mckay27/hstat/HW/doc/GDEY42T81-FT02-CAD_00.png

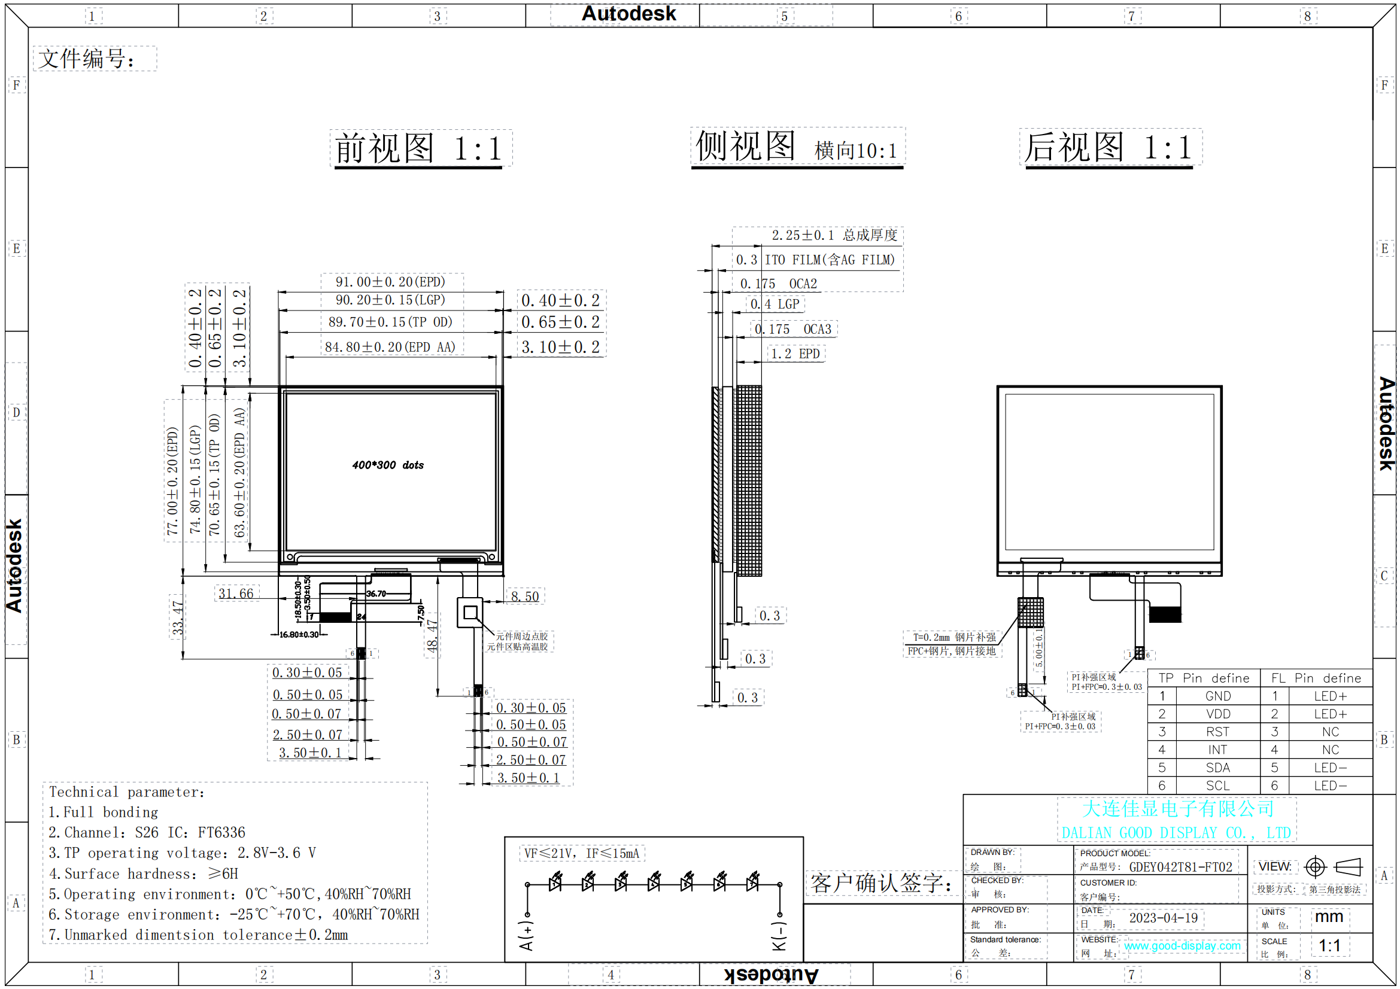
HW/doc/GDEY42T81-FT02-CAD_00.png
