mckay27/hstat/HW/3d-models/display_board.step

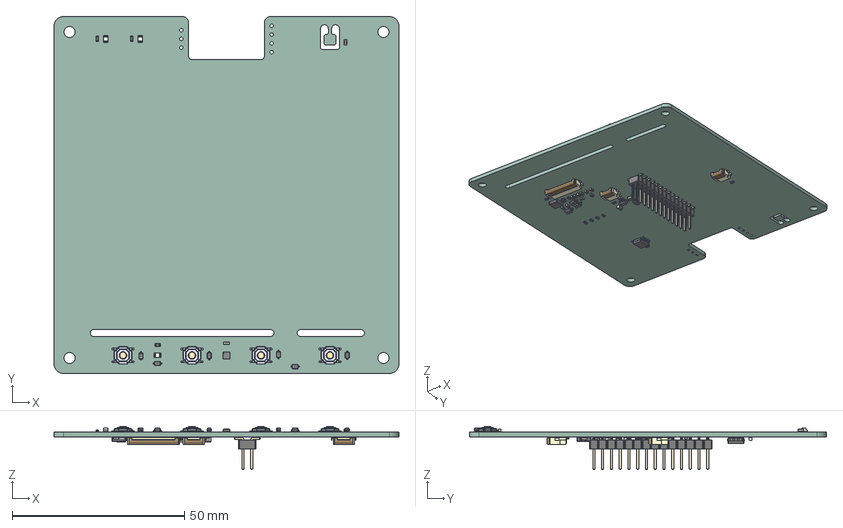
[picture p2: CAD file, 2026-02-15]
HW/3d-models/display_board.step
100.0 x 103.5 x 12.5 mm
R_0603_1608Metric x 11
D_SOD-323 x 6
TS-1187A-B-A-B x 4
LTR-303ALS-01_LTO
LED_0805_2012Metric x 3
C_0603_1608Metric x 14
lock x 3
pins x 3
C_0805_2012Metric x 2
L_Changjiang_FNR4012S
D_SOD-123 x 4
SOT-23-6
PinHeader_2x14_P2.54mm_Vertical_SMD
SOIC-8_3.9x4.9mm_P1.27mm
SOT-323_SC-70
display_board_PCB
