mckay27/hstat/HW/display_board/3d-models/LTR-303ALS-01_LTO.step

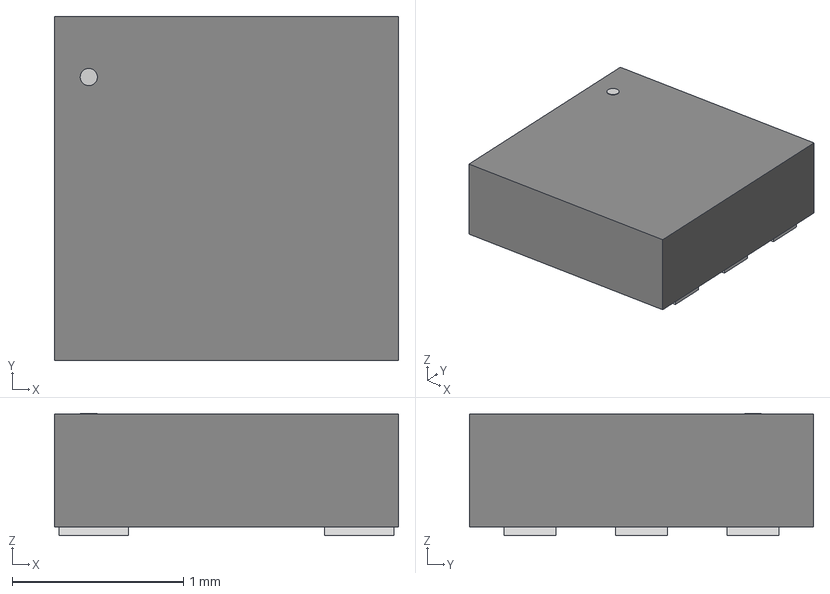
[picture p3: CAD file, 2026-02-15]
HW/display_board/3d-models/LTR-303ALS-01_LTO.step
2.01 x 2.01 x 0.714 mm
