mckay27/hstat/HW/main_board/3d-models/TS-1187A-B-A-B.STEP

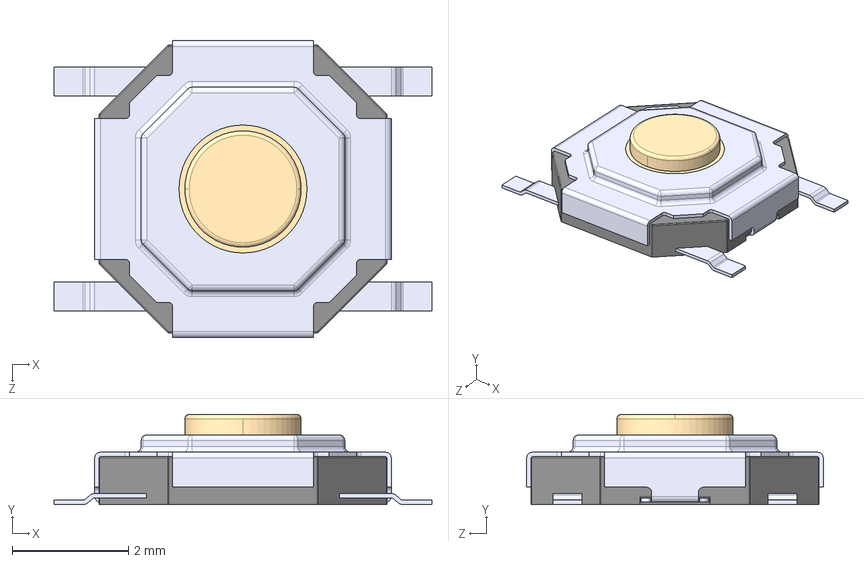
[picture p4: CAD file, 2026-02-15]
HW/main_board/3d-models/TS-1187A-B-A-B.STEP
6.50 x 1.55 x 5.10 mm
