mckay27/hstat/HW/display_board/display_board.kicad_pcb

## KiCad design HW/display_board/display_board.kicad_pcb (2026-02-26)

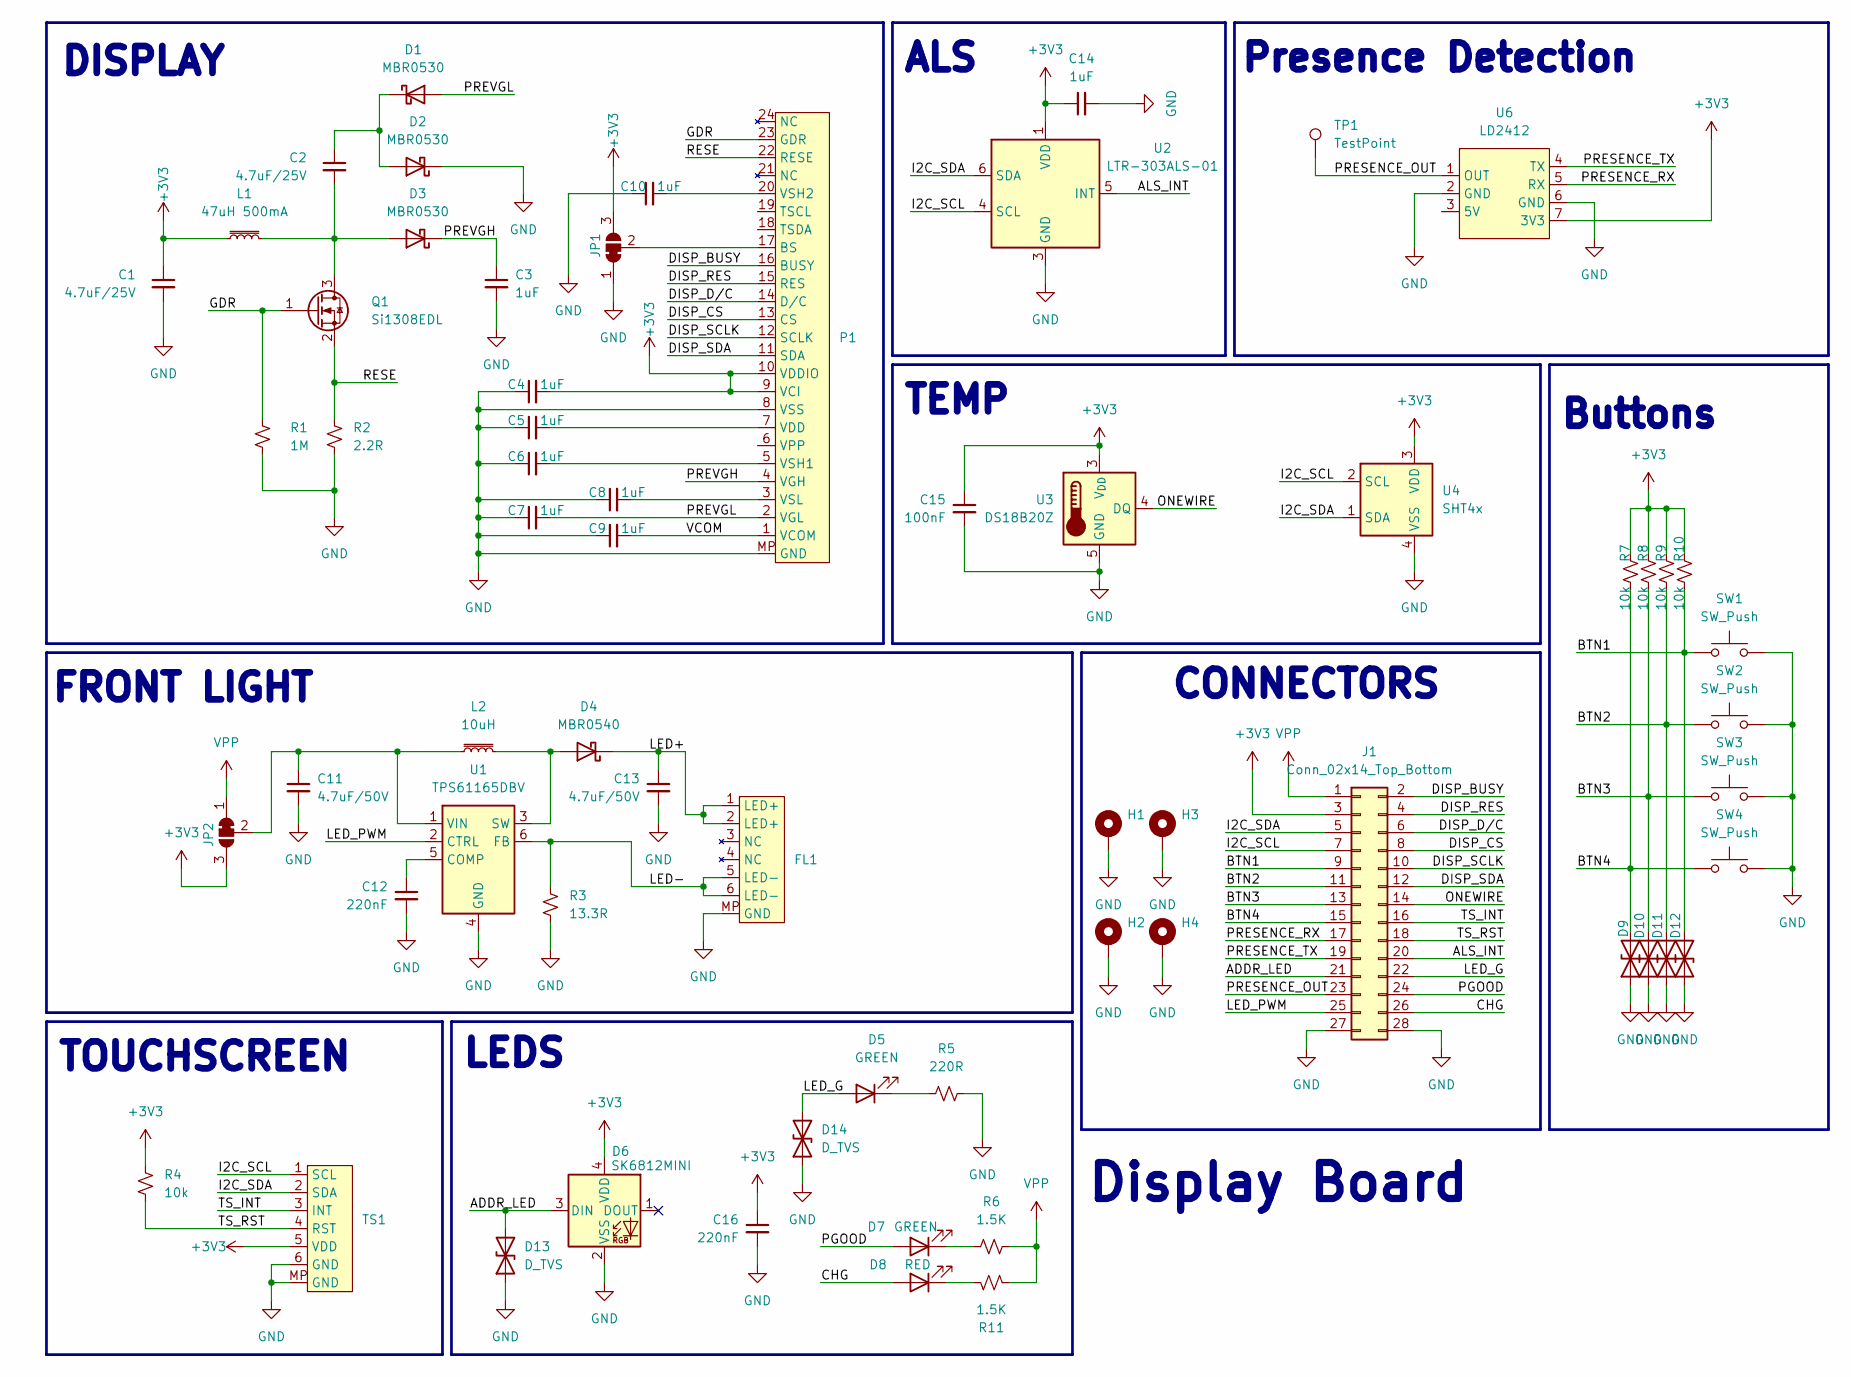
[picture p5: schematic display_board.kicad_sch, hstat display board]

Parts:
C1, C2: 4.7uF/25V; C_0603_1608Metric; PartsBox ID aw5pxnppqwhgq9d4hbptg59tfp
C3, C4, C5, C6, C7, C8, C9, C10, C14: 1uF; C_0603_1608Metric; PartsBox ID 6kadbs4vvekm59a2tdn2x98ymn
C11, C13: 4.7uF/50V; C_0805_2012Metric; PartsBox ID 7j02rd1hp8ghk8tj1z507f8pqg
C12, C16: 220nF; C_0603_1608Metric; PartsBox ID bsj51sepbckhc9y04nejax5532
C15: 100nF; C_0603_1608Metric; PartsBox ID 6afr1f2my2jjj8vs6v1p4rpr25
D1, D2, D3: MBR0530; D_SOD-123; MPN MBR0530-TP
D4: MBR0540; D_SOD-123; PartsBox ID 77578v3zwgkcma6xaqdbw1041c
D5, D7: GREEN; LED_0805_2012Metric; MPN KT-0805G
D6: SK6812MINI; LED_SK6812MINI_PLCC4_3.5x3.5mm_P1.75mm; MPN SK6812MINI-HS
D8: RED; LED_0805_2012Metric; MPN NCD0805R1
D9, D10, D11, D12, D13, D14: D_TVS; D_SOD-323; MPN H8VHD3B
FL1: AFC24-S06FIA-00
H1, H2, H3, H4: MountingHole_Pad; MountingHole_3.2mm_M3_ISO7380
J1: Conn_02x14_Top_Bottom; PinHeader_2x14_P2.54mm_Vertical_SMD
JP1, JP2: SolderJumper_3_Bridged12; SolderJumper-3_P1.3mm_Bridged12_RoundedPad1.0x1.5mm
L1: 47uH 500mA; L_Changjiang_FNR4012S; MPN FNR4012S470MT
L2: 10uH; L_Taiyo-Yuden_NR-40xx; MPN NRS4018T100MDGJ
P1: AFC24-S24FIA-00
Q1: Si1308EDL; SOT-323_SC-70; MPN SI1308EDL-T1-GE3
R1: 1M; R_0603_1608Metric; PartsBox ID 6jt3vpkk78jdvawzvaeg0wm6yf
R2: 2.2R; R_0603_1608Metric; PartsBox ID 8vn7xtt6zthxrb24xq1m7pnxd6
R3: 13.3R; R_0603_1608Metric; PartsBox ID 251d633bemhrbapgvqna90sr9j
R4, R7, R8, R9, R10: 10k; R_0603_1608Metric; PartsBox ID df49r6pnvckv7ajxacv2mbgt3r
R5: 220R; R_0603_1608Metric; PartsBox ID 1qgbwbrhs2jpe97grc235zphth
R6, R11: 1.5K; R_0603_1608Metric; PartsBox ID 8a565xcwbcjcr9p1vng5eaq7bh
SW1, SW2, SW3, SW4: SW_Push; SW_Push_1P1T_XKB_TS-1187A; MPN TS-1187A-B-A-B
TP1: TestPoint; TestPoint_Pad_2.0x2.0mm
TS1: AFC24-S06FIA-00
U1: TPS61165DBV; SOT-23-6; MPN TPS61165DBV
U2: LTR-303ALS-01; Lite-On_LTR-303ALS-01; MPN LTR-303ALS-01
U3: DS18B20Z; SOIC-8_3.9x4.9mm_P1.27mm; MPN DS18B20Z
U4: SHT4x; Sensirion_DFN-4_1.5x1.5mm_P0.8mm_SHT4x_NoCentralPad; MPN SHT41-AD1B-R2
U6: LD2412; MPN LD2412

Connections:
+3V3: C1.1, C4.2, C14.1, C15.1, C16.1, D6.4 (VDD), J1.3, JP1.3 (B), JP2.3 (B), L1.1, P1.9 (VCI), P1.10 (VDDIO), R4.1, R7.1, R8.1, R9.1, R10.1, TS1.5 (VDD), U2.1 (VDD), U3.3 (V_{DD}), U4.3 (VDD), U6.7 (3V3)
/ADDR_LED: D6.3 (DIN), D13.2 (A2), J1.21
/ALS_INT: J1.20, U2.5 (INT)
/BTN1: D12.2 (A2), J1.9, R10.2, SW1.1
/BTN2: D11.2 (A2), J1.11, R9.2, SW2.1
/BTN3: D10.2 (A2), J1.13, R8.2, SW3.1
/BTN4: D9.2 (A2), J1.15, R7.2, SW4.1
/CHG: D8.2 (A), J1.26
/DISP_BUSY: J1.2, P1.16 (BUSY)
/DISP_CS: J1.8, P1.13 (CS)
/DISP_D/C: J1.6, P1.14 (D/C)
/DISP_RES: J1.4, P1.15 (RES)
/DISP_SCLK: J1.10, P1.12 (SCLK)
/DISP_SDA: J1.12, P1.11 (SDA)
/GDR: P1.23 (GDR), Q1.1 (G), R1.1
/I2C_SCL: J1.7, TS1.1 (SCL), U2.4 (SCL), U4.2 (SCL)
/I2C_SDA: J1.5, TS1.2 (SDA), U2.6 (SDA), U4.1 (SDA)
/LED+: C13.1, D4.1 (K), FL1.1 (LED+), FL1.2 (LED+)
/LED-: FL1.5 (LED-), FL1.6 (LED-), R3.1, U1.6 (FB)
/LED_G: D5.2 (A), D14.2 (A2), J1.22
/LED_PWM: J1.25, U1.2 (CTRL)
/ONEWIRE: J1.14, U3.4 (DQ)
/PGOOD: D7.2 (A), J1.24
/PRESENCE_OUT: J1.23, TP1.1, U6.1 (OUT)
/PRESENCE_RX: J1.17, U6.5 (RX)
/PRESENCE_TX: J1.19, U6.4 (TX)
/PREVGH: C3.1, D3.1 (K), P1.4 (VGH)
/PREVGL: C7.2, D1.2 (A), P1.2 (VGL)
/RESE: P1.22 (RESE), Q1.2 (S), R2.1
/TS_INT: J1.16, TS1.3 (INT)
/TS_RST: J1.18, R4.2, TS1.4 (RST)
/VCOM: C9.2, P1.1 (VCOM)
GND: C1.2, C3.2, C4.1, C5.1, C6.1, C7.1, C8.1, C9.1, C10.1, C11.2, C12.2, C13.2, C14.2, C15.2, C16.2, D2.1 (K), D6.2 (VSS), D9.1 (A1), D10.1 (A1), D11.1 (A1), D12.1 (A1), D13.1 (A1), D14.1 (A1), FL1.MP (GND), H1.1, H2.1, H3.1, H4.1, J1.27, J1.28, JP1.1 (A), P1.8 (VSS), P1.MP (GND), R1.2, R2.2, R3.2, R5.2, SW1.2, SW2.2, SW3.2, SW4.2, TS1.6 (GND), TS1.MP (GND), U1.4 (GND), U2.3 (GND), U3.5 (GND), U4.4 (VSS), U6.2 (GND), U6.6 (GND)
unnamed: C2.1, D1.1 (K), D2.2 (A)
unnamed: C2.2, D3.2 (A), L1.2, Q1.3 (D)
unnamed: D4.2 (A), L2.2, U1.3 (SW)
unnamed: D5.1 (K), R5.1
unnamed: D7.1 (K), R6.2
unnamed: D8.1 (K), R11.1
unnamed: JP1.2 (C), P1.17 (BS)
unnamed: C11.1, JP2.2 (C), L2.1, U1.1 (VIN)
unnamed: C5.2, P1.7 (VDD)
unnamed: C6.2, P1.5 (VSH1)
unnamed: C10.2, P1.20 (VSH2)
unnamed: C8.2, P1.3 (VSL)
unnamed: C12.1, U1.5 (COMP)
VPP: J1.1, JP2.1 (A), R6.1, R11.2

Notes on the sheet:
DISPLAY
Presence Detection
TEMP
Display Board
LEDS
CONNECTORS
Buttons
TOUCHSCREEN
ALS
FRONT LIGHT

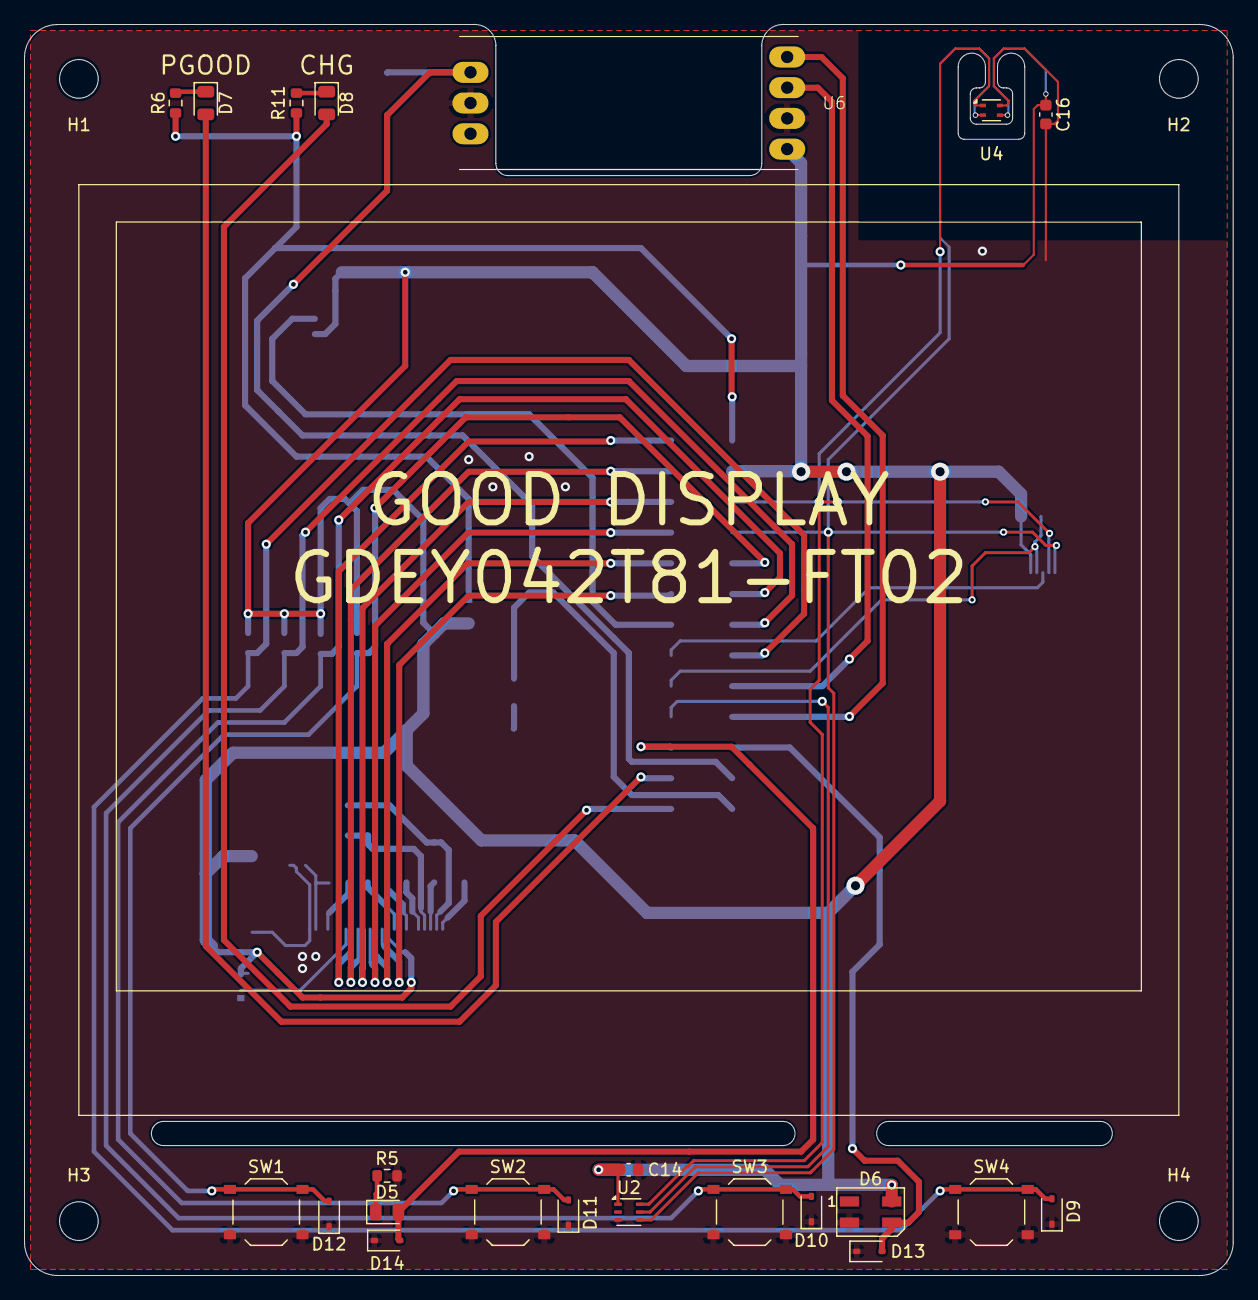
[picture p6: board display_board.kicad_pcb from above]

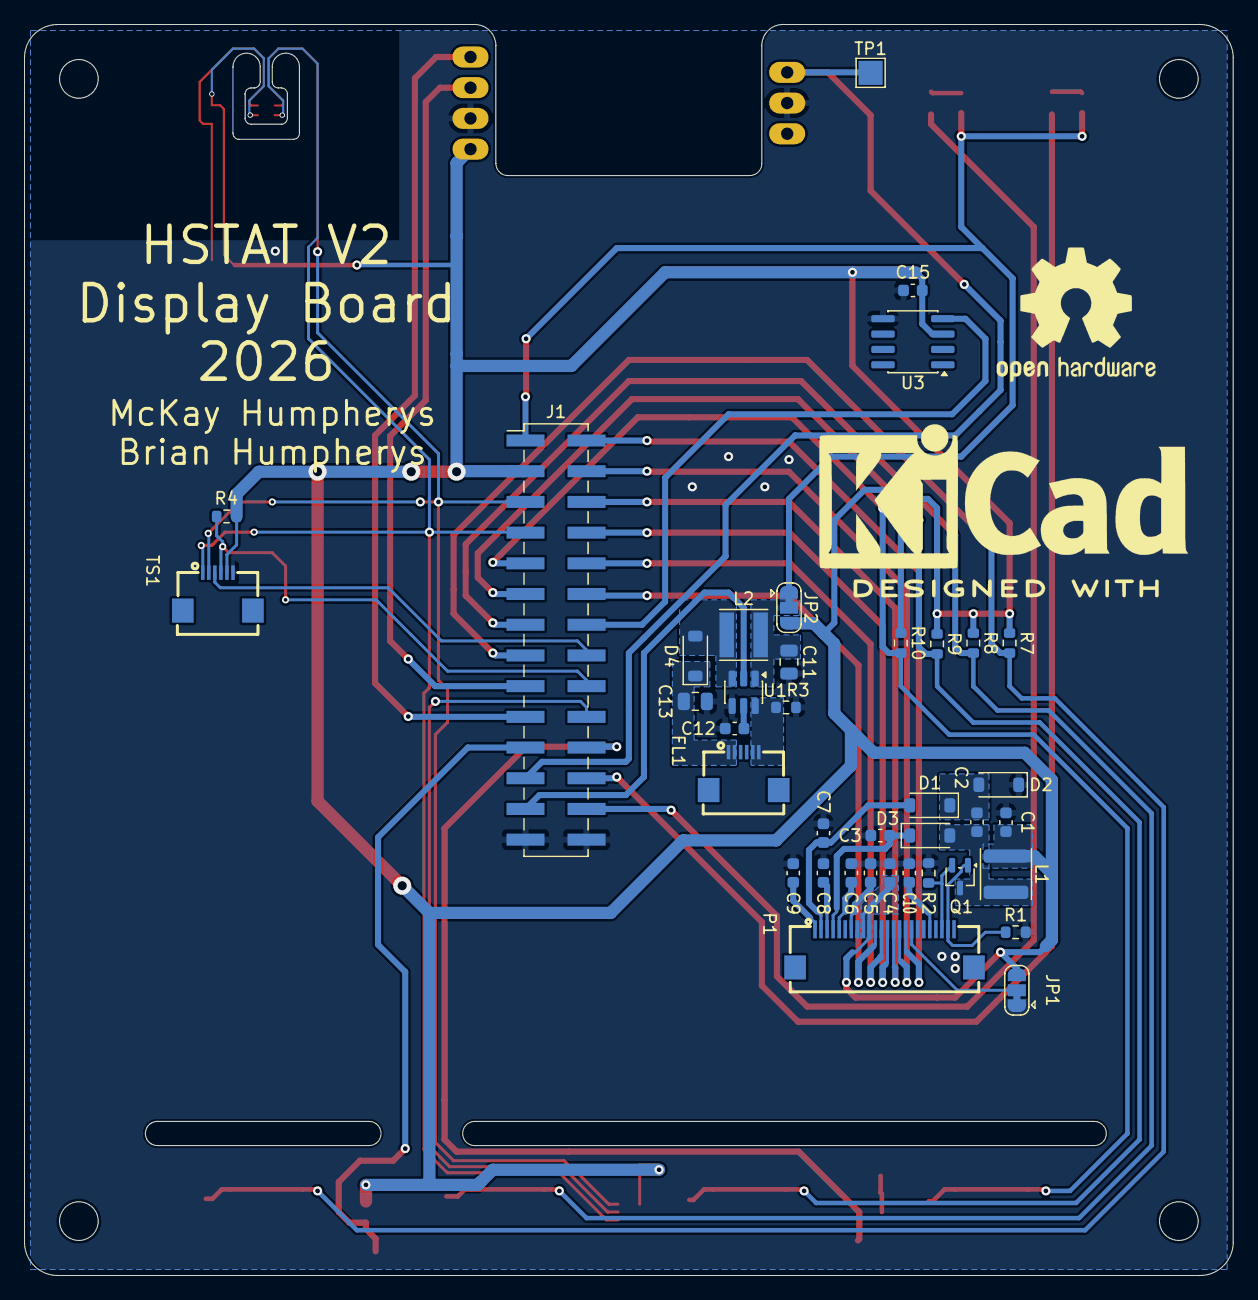
[picture p7: board display_board.kicad_pcb from below]

Board: 2 copper layers, 100.0 x 103.5 mm, 64 parts (38 on the bottom side), 47 nets.
