mckay27/hstat/HW/main_board/main_board.kicad_pcb

## KiCad design HW/main_board/main_board.kicad_pcb (2026-02-16)

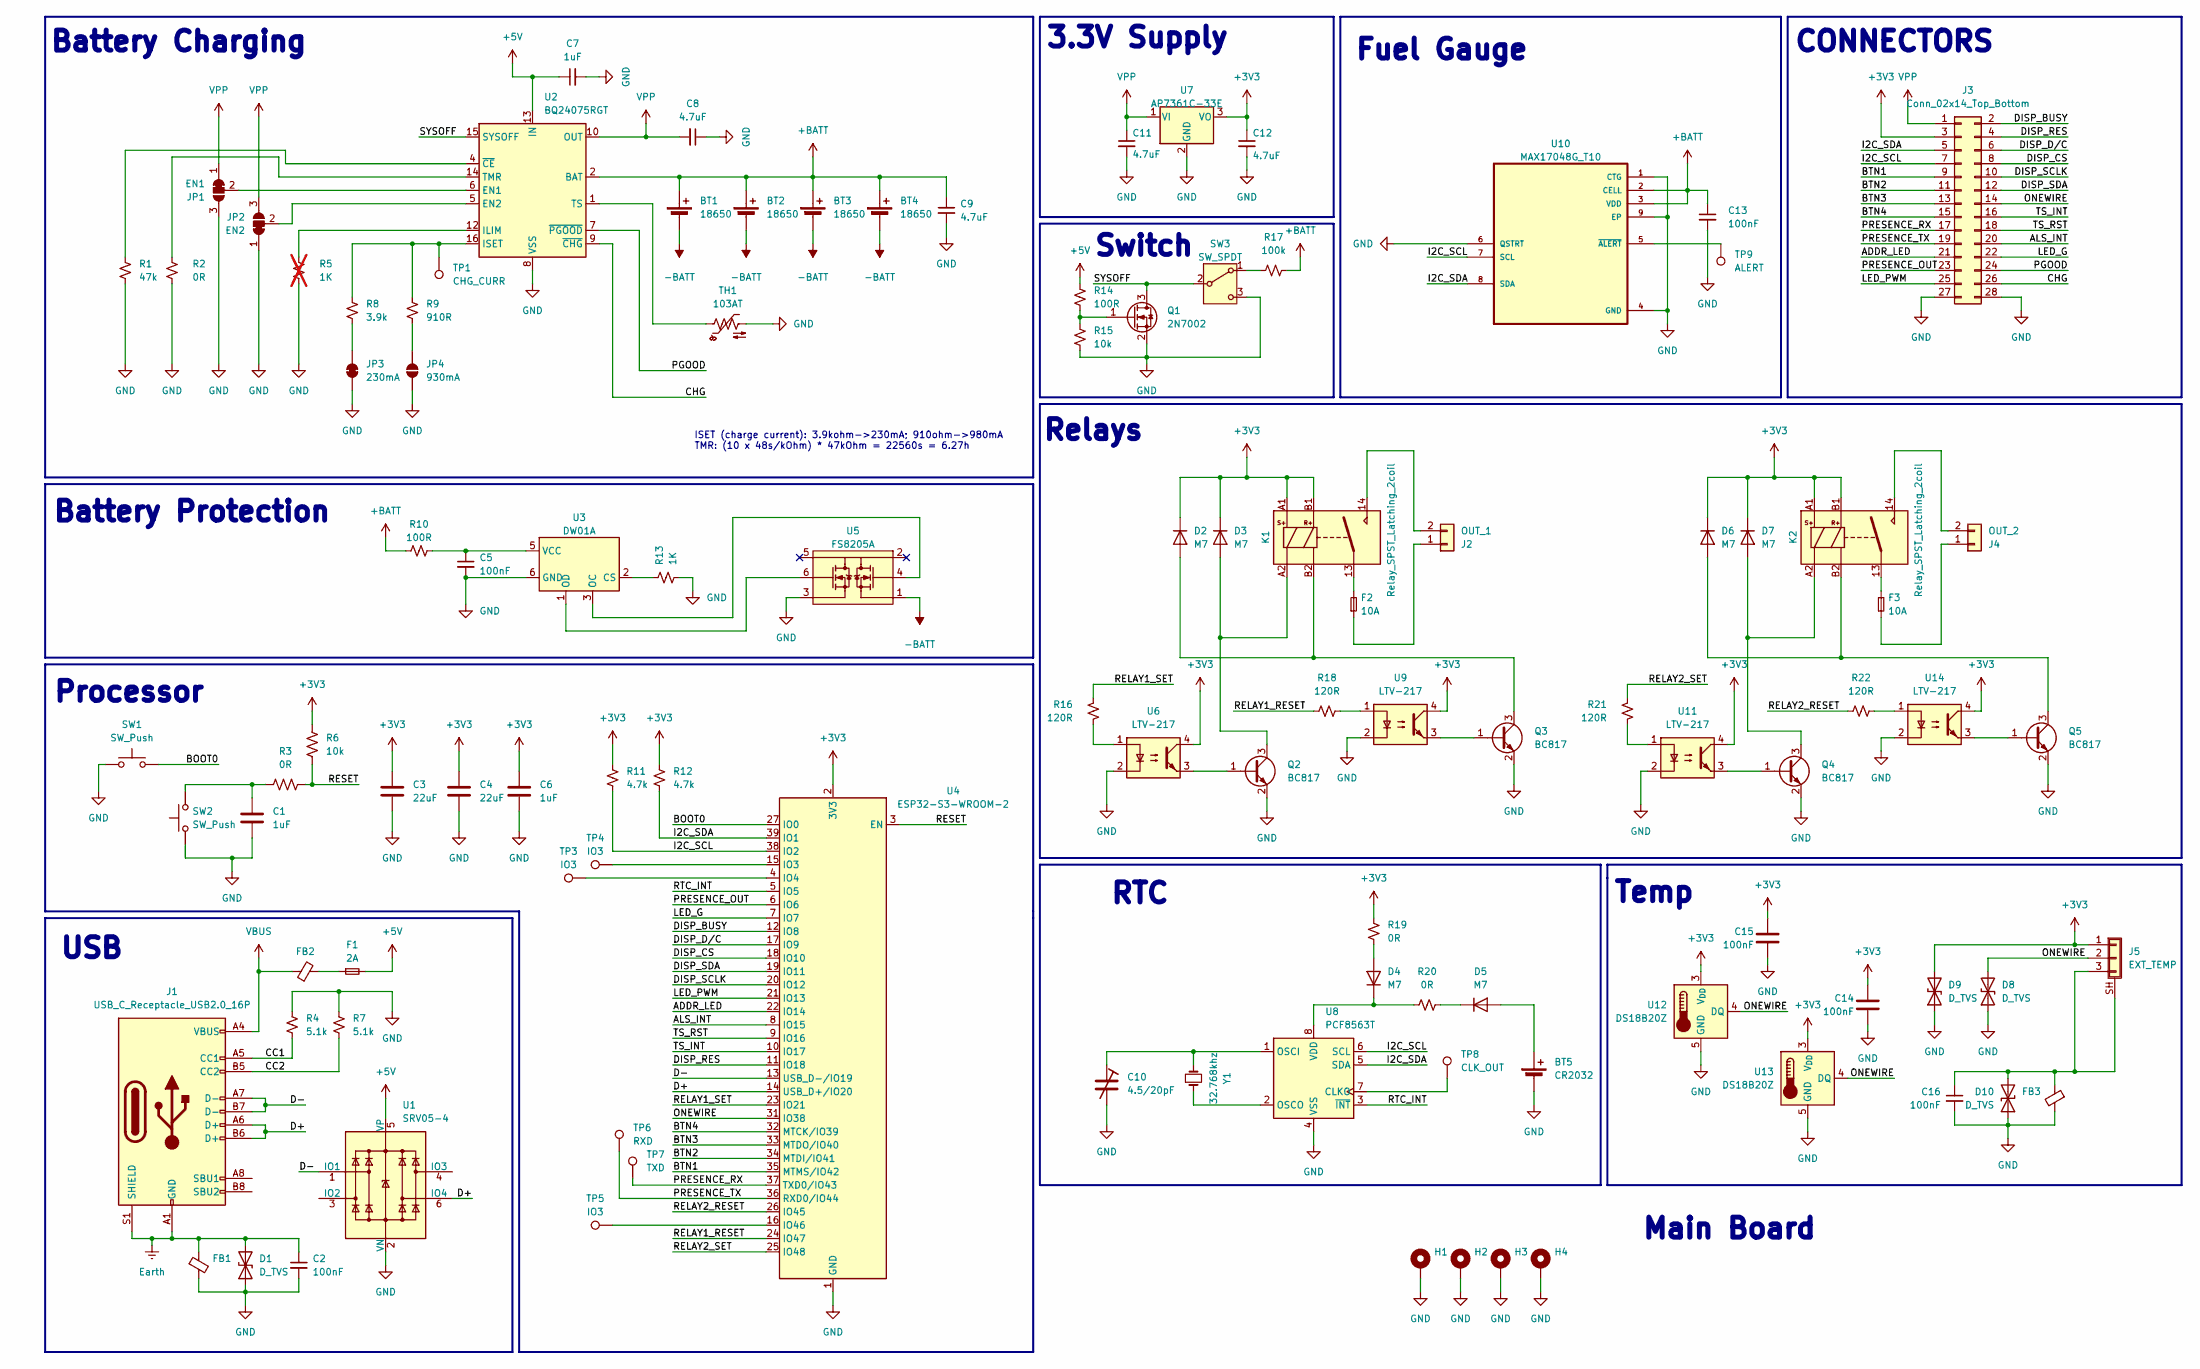
[picture p8: schematic main_board.kicad_sch, Main Board]

Parts:
BT1, BT2, BT3, BT4: 18650; 1043-keystone-18650; MPN 1043
BT5: CR2032; BatteryHolder_Keystone_1058_1x2032; MPN 1058
C1, C6, C7: 1uF; C_0603_1608Metric; PartsBox ID 6kadbs4vvekm59a2tdn2x98ymn
C2, C5, C13, C14, C15, C16: 100nF; C_0603_1608Metric; PartsBox ID 6afr1f2my2jjj8vs6v1p4rpr25
C3, C4: 22uF; C_0603_1608Metric; PartsBox ID 11f9t6q8q6hhk8b1pmjvgccz5x
C8, C9, C11, C12: 4.7uF; C_0603_1608Metric; PartsBox ID aw5pxnppqwhgq9d4hbptg59tfp
C10: 4.5/20pF; C_Trimmer_Voltronics_JZ; MPN JZ200HV
D1, D8, D9, D10: D_TVS; D_SOD-323; MPN H8VHD3B
D2, D3, D4, D5, D6, D7: M7; D_SMA; PartsBox ID 3vcxfjzjhpj7690trekrvkgr7w
F1: 2A; Fuse_1206_3216Metric_Pad1.42x1.75mm_HandSolder
F2, F3: 10A; Fuseholder_Clip-5x20mm_Littelfuse_111_Lateral_P18.80x5.00mm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; MPN 01110501Z
FB1, FB2, FB3: FerriteBead_Small; L_0603_1608Metric; MPN BLM18PG121SN1D
H1, H2, H3, H4: MountingHole_Pad; MountingHole_3.2mm_M3_ISO7380
J1: USB_C_Receptacle_USB2.0_16P; USB_C_Receptacle_G-Switch_GT-USB-7010ASV; MPN GT-USB-7010ASV
J2: OUT_1; CONN2_2604-1102_WAG; MPN 2604-1102
J3: Conn_02x14_Top_Bottom; PinSocket_2x14_P2.54mm_Vertical_SMD
J4: OUT_2; CONN2_2604-1102_WAG; MPN 2604-1102
J5: EXT_TEMP; PHOENIX_1771033; MPN 1771033
JP1: EN1; SolderJumper-3_P1.3mm_Bridged12_RoundedPad1.0x1.5mm
JP2: EN2; SolderJumper-3_P1.3mm_Bridged12_RoundedPad1.0x1.5mm
JP3: 230mA; SolderJumper-2_P1.3mm_Bridged_RoundedPad1.0x1.5mm
JP4: 930mA; SolderJumper-2_P1.3mm_Open_RoundedPad1.0x1.5mm
K1, K2: Relay_SPST_Latching_2coil; RELAY_G6CK-1117P-US_OMR; MPN G6CK-1117P-US-DC3
Q1: 2N7002; SOT-23; MPN 2N7002
Q2, Q3, Q4, Q5: BC817; SOT-23; MPN BC817-40
R1: 47k; R_0603_1608Metric; PartsBox ID 1aemmt28hmjbp9y1k30rczecpr
R2, R3, R19, R20: 0R; R_0603_1608Metric; PartsBox ID 8qd6rd2jk8jw398ybjyyrmq1tq
R4, R7: 5.1k; R_0603_1608Metric; PartsBox ID 9ecv7q3vv2knm8vest68b07d9j
R5: 1K; R_0603_1608Metric; PartsBox ID e64yh28w3ej2mbe5sh0xf25qpt; not fitted
R6, R15: 10k; R_0603_1608Metric; PartsBox ID df49r6pnvckv7ajxacv2mbgt3r
R8: 3.9k; R_0603_1608Metric; PartsBox ID 5v44h5wt9ck18a2815smpxngts
R9: 910R; R_0603_1608Metric; PartsBox ID efjv3egq1rhyg8vvdsvfw39abg
R10, R14: 100R; R_0603_1608Metric; PartsBox ID dqk7283n2thpca2y9nhycmgdpt
R11, R12: 4.7k; R_0603_1608Metric; PartsBox ID cb7fy4f2b2jq09t4n4p298ayaa
R13: 1K; R_0603_1608Metric; PartsBox ID e64yh28w3ej2mbe5sh0xf25qpt
R16, R18, R21, R22: 120R; R_0603_1608Metric; PartsBox ID 6kyk5zk2zegvt8f9vh34bzh7ka
R17: 100k; R_0603_1608Metric; PartsBox ID ad7wkgw7d2hthbb72xtkfgq7rp
SW1, SW2: SW_Push; SW_Push_1P1T_XKB_TS-1187A; MPN TS-1187A-B-A-B
SW3: SW_SPDT; SW_E-Switch_EG1224_SPDT_Angled; MPN EG1224
TH1: 103AT; R_0603_1608Metric; MPN B57332V5103F360
TP1: CHG_CURR; TestPoint_Pad_2.0x2.0mm
TP3, TP4, TP5: IO3; TestPoint_Pad_2.0x2.0mm
TP6: RXD; TestPoint_Pad_2.0x2.0mm
TP7: TXD; TestPoint_Pad_2.0x2.0mm
TP8: CLK_OUT; TestPoint_Loop_D2.54mm_Drill1.5mm_Beaded
TP9: ALERT; TestPoint_Pad_2.0x2.0mm
U1: SRV05-4; SOT-23-6; MPN SRV05-4-P-T7
U2: BQ24075RGT; VQFN-16-1EP_3x3mm_P0.5mm_EP1.6x1.6mm; MPN BQ24075TRGTR
U3: DW01A; SOT-23-6; MPN DW01A
U4: ESP32-S3-WROOM-2; MPN ESP32-S3-WROOM-2-N32R16V
U5: FS8205A; SOT-23-6; MPN FS8205A
U6, U9, U11, U14: LTV-217; SOP-4_4.4x2.6mm_P1.27mm; MPN LTV-217-B-G
U7: AP7361C-33E; SOT-223-3_TabPin2; MPN AP7361C-33E-13
U8: PCF8563T; SOIC-8_3.9x4.9mm_P1.27mm; MPN PCF8563T/5,518
U10: MAX17048G_T10; SON50P200X200X80-9N; MPN MAX17048G+T10
U12, U13: DS18B20Z; SOIC-8_3.9x4.9mm_P1.27mm; MPN DS18B20Z
Y1: 32.768khz; Crystal_SMD_3215-2Pin_3.2x1.5mm; MPN Q13FC13500004

Connections:
+5V: C7.1, F1.2, R14.1, U1.5 (VP), U2.13 (IN)
+BATT: BT1.1 (+), BT2.1 (+), BT3.1 (+), BT4.1 (+), C9.1, C13.1, R10.1, R17.2, U2.2 (BAT), U2.3 (BAT), U10.2 (CELL), U10.3 (VDD)
-BATT: BT1.2 (-), BT2.2 (-), BT3.2 (-), BT4.2 (-), U5.1 (S1)
/ADDR_LED: J3.21, U4.22 (IO14)
/ALS_INT: J3.20, U4.8 (IO15)
/BOOT0: SW1.2, U4.27 (IO0)
/BTN1: J3.9, U4.35 (MTMS/IO42)
/BTN2: J3.11, U4.34 (MTDI/IO41)
/BTN3: J3.13, U4.33 (MTDO/IO40)
/BTN4: J3.15, U4.32 (MTCK/IO39)
/CC1: J1.A5 (CC1), R4.2
/CC2: J1.B5 (CC2), R7.2
/CHG: J3.26, U2.9 (~CHG)
/D+: J1.A6 (D+), J1.B6 (D+), U1.6 (IO4), U4.14 (USB_D+/IO20)
/D-: J1.A7 (D-), J1.B7 (D-), U1.1 (IO1), U4.13 (USB_D-/IO19)
/DISP_BUSY: J3.2, U4.12 (IO8)
/DISP_CS: J3.8, U4.18 (IO10)
/DISP_D/C: J3.6, U4.17 (IO9)
/DISP_RES: J3.4, U4.11 (IO18)
/DISP_SCLK: J3.10, U4.20 (IO12)
/DISP_SDA: J3.12, U4.19 (IO11)
/I2C_SCL: J3.7, R11.2, U4.38 (IO2), U8.6 (SCL), U10.7 (SCL)
/I2C_SDA: J3.5, R12.2, U4.39 (IO1), U8.5 (SDA), U10.8 (SDA)
/LED_G: J3.22, U4.7 (IO7)
/LED_PWM: J3.25, U4.21 (IO13)
/ONEWIRE: D8.2 (A2), J3.14, J5.2, U4.31 (IO38), U12.4 (DQ), U13.4 (DQ)
/PGOOD: J3.24, U2.7 (~PGOOD)
/PRESENCE_OUT: J3.23, U4.6 (IO6)
/PRESENCE_RX: J3.17, TP7.1, U4.37 (TXD0/IO43)
/PRESENCE_TX: J3.19, TP6.1, U4.36 (RXD0/IO44)
/RELAY1_RESET: R18.1, U4.24 (IO47)
/RELAY1_SET: R16.1, U4.23 (IO21)
/RELAY2_RESET: R22.1, U4.26 (IO45)
/RELAY2_SET: R21.1, U4.25 (IO48)
/RESET: R3.2, R6.2, U4.3 (EN)
/RTC_INT: U4.5 (IO5), U8.3 (~INT)
/SYSOFF: Q1.3 (D), SW3.2 (B), U2.15 (SYSOFF)
/TS_INT: J3.16, U4.10 (IO17)
/TS_RST: J3.18, U4.9 (IO16)
Earth: C2.1, D1.2 (A2), FB1.1, J1.A1 (GND), J1.A12 (GND), J1.B1 (GND), J1.B12 (GND), J1.S1 (SHIELD)
unnamed: BT5.1 (+), D5.2 (A)
unnamed: C1.1, R3.1, SW2.2
unnamed: D2.2 (A), K1.B2, Q3.3 (C)
unnamed: D3.2 (A), K1.A2, Q2.3 (C)
unnamed: D4.2 (A), R19.1
unnamed: D4.1 (K), R20.1, U8.8 (VDD)
unnamed: D5.1 (K), R20.2
unnamed: D6.2 (A), K2.B2, Q5.3 (C)
unnamed: D7.2 (A), K2.A2, Q4.3 (C)
unnamed: C16.1, D10.2 (A2), FB3.1, J5.3, J5.SH (Shield)
unnamed: F1.1, FB2.2
unnamed: F2.2, K1.13
unnamed: F3.2, K2.13
unnamed: F2.1, J2.1
unnamed: J2.2, K1.14
unnamed: F3.1, J4.1
unnamed: J4.2, K2.14
unnamed: JP1.2 (C), U2.6 (EN1)
unnamed: JP2.2 (C), U2.5 (EN2)
unnamed: JP3.2 (B), R8.2
unnamed: JP4.2 (B), R9.2
unnamed: Q1.1 (G), R14.2, R15.1
unnamed: Q2.1 (B), U6.3
unnamed: Q3.1 (B), U9.3
unnamed: Q4.1 (B), U11.3
unnamed: Q5.1 (B), U14.3
unnamed: R16.2, U6.1
unnamed: R18.2, U9.1
unnamed: R21.2, U11.1
unnamed: R22.2, U14.1
unnamed: R17.1, SW3.1 (A)
unnamed: R5.1, U2.12 (ILIM)
unnamed: R8.1, R9.1, TP1.1, U2.16 (ISET)
unnamed: R2.1, U2.14 (TMR)
unnamed: TH1.1, U2.1 (TS)
unnamed: R1.1, U2.4 (~CE)
unnamed: R13.1, U3.2 (CS)
unnamed: U3.3 (OC), U5.4 (G1)
unnamed: U3.1 (OD), U5.6 (G2)
unnamed: C5.1, R10.2, U3.5 (VCC)
unnamed: TP4.1, U4.15 (IO3)
unnamed: TP3.1, U4.4 (IO4)
unnamed: TP5.1, U4.16 (IO46)
unnamed: TP8.1, U8.7 (CLKO)
unnamed: C10.1, U8.1 (OSCI), Y1.2
unnamed: U8.2 (OSCO), Y1.1
unnamed: TP9.1, U10.5 (~ALERT)
VBUS: FB2.1, J1.A4 (VBUS), J1.A9 (VBUS), J1.B4 (VBUS), J1.B9 (VBUS)
VPP: C8.2, C11.1, J3.1, JP1.1 (A), JP2.3 (B), U2.10 (OUT), U2.11 (OUT), U7.1 (VI)

Notes on the sheet:
USB
Temp
Processor
Main Board
Fuel Gauge
Relays
Battery Charging
Battery Protection
CONNECTORS
RTC
Switch
3.3V Supply
ISET (charge current): 3.9kohm->230mA; 910ohm->980mA TMR: (10 x 48s/kOhm) * 47kOhm = 22560s = 6.27h

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
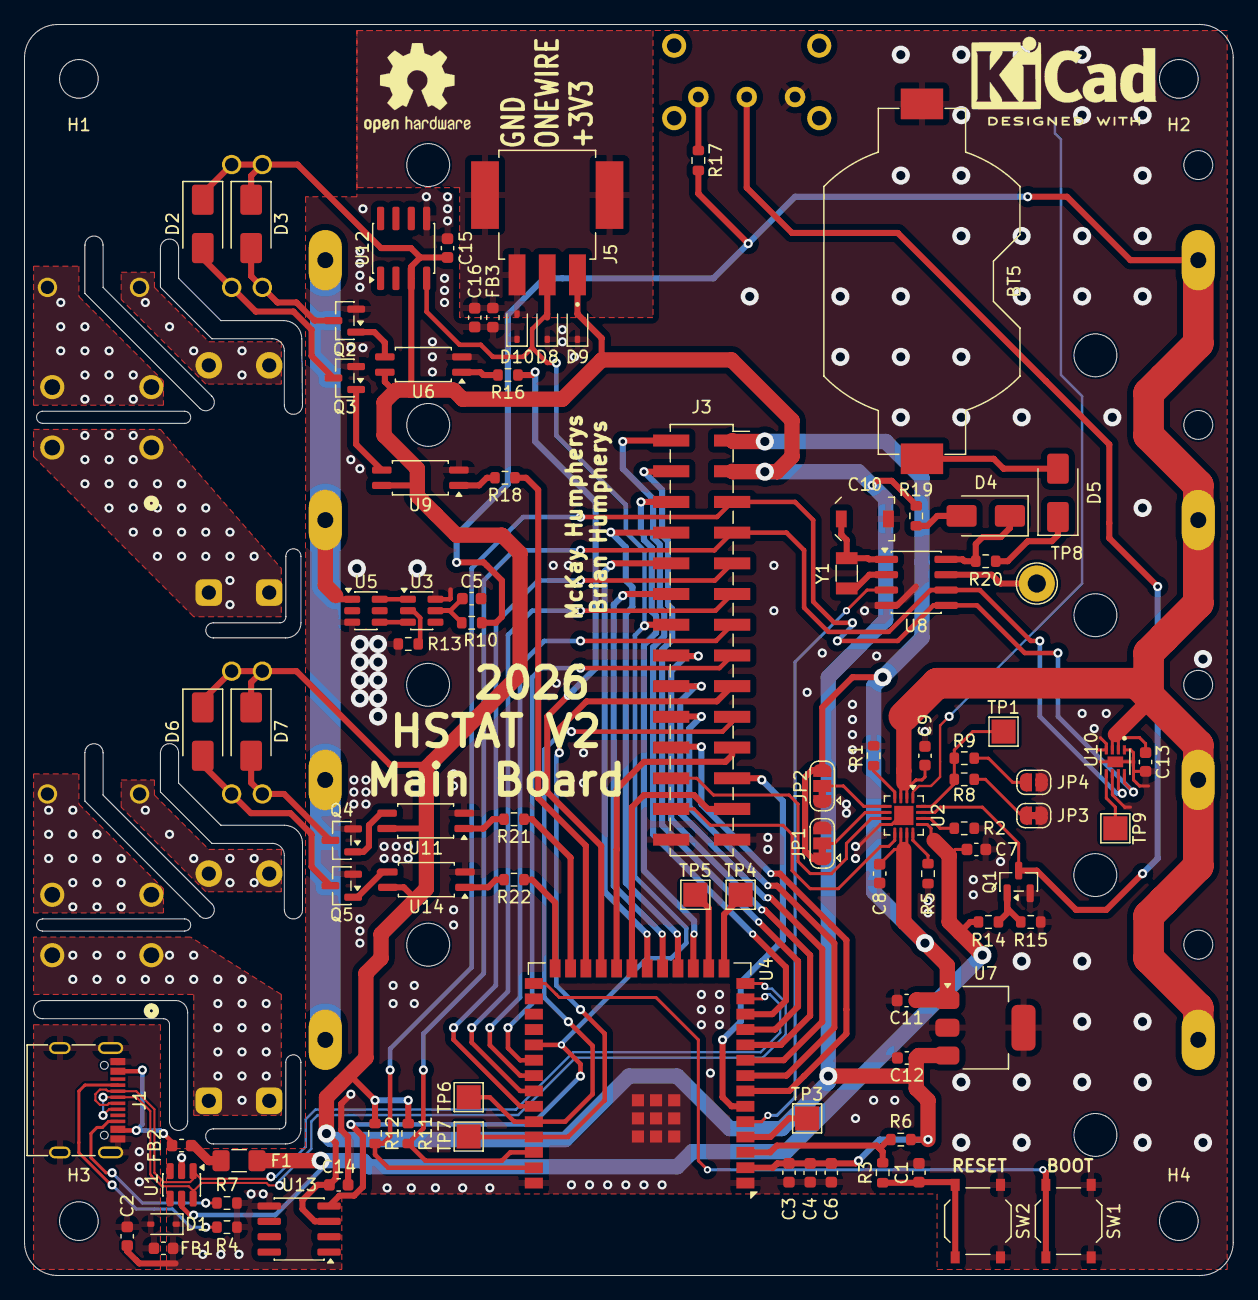
[picture p9: board main_board.kicad_pcb from above]

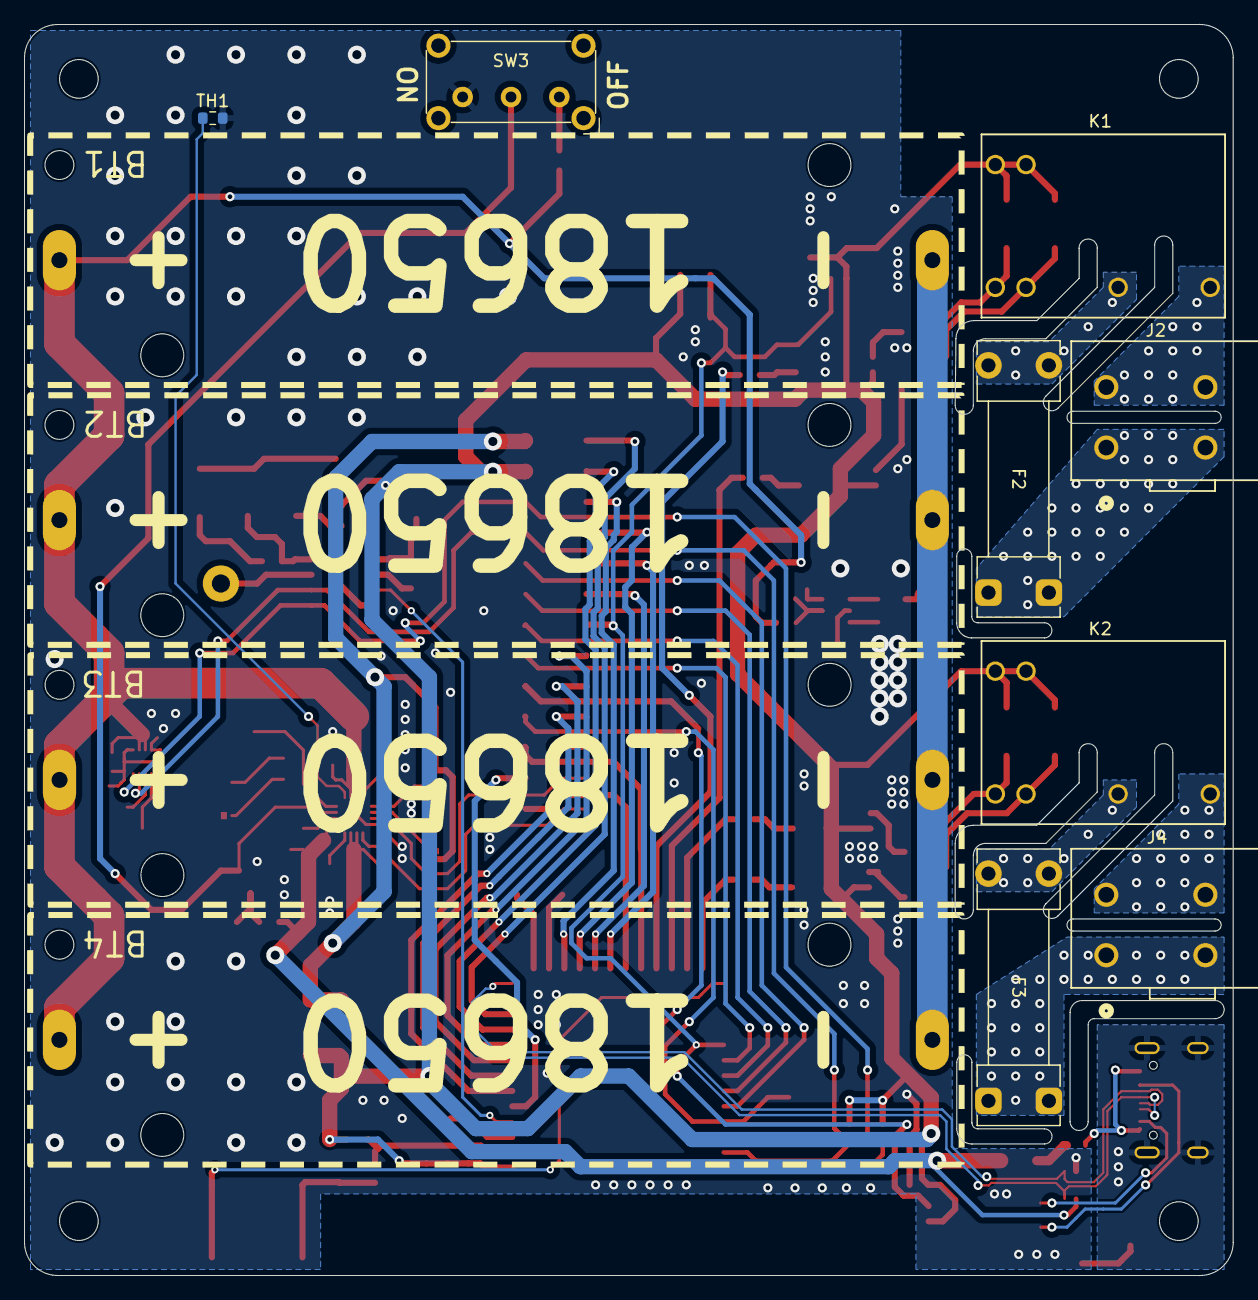
[picture p10: board main_board.kicad_pcb from below]

Board: 2 copper layers, 100.0 x 103.5 mm, 106 parts (12 on the bottom side), 91 nets.
