mckay27/hstat/(commit log)

2025-02-02 Add logos etc.
    [BOM-hstat.csv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]
2025-02-02 new schematic
    [BOM-hstat.csv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]
2025-02-02 v1.0 ordered
    [hstat-CuBottom.gbr, hstat-CuTop.gbr, hstat-EdgeCuts.gbr, hstat-MaskBottom.gbr, hstat-MaskTop.gbr, hstat-NPTH.drl, hstat-PTH.drl, hstat-PasteBottom.gbr]
2025-03-24 Fix Temperature Calibration Syntax
    [hstat.yaml]
2026-01-31 Move to V1 folder
    [BOM-hstat.csv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]
2026-02-01 hstat dev in progress
    [hstat-v2.kicad_pcb, hstat-v2.kicad_sch]
2026-02-06 Before board split
    [hstat-v2.kicad_sch]
2026-02-06 In progress
    [display_board.kicad_pcb, display_board.kicad_sch]
2026-02-07 Schematic tided up on display board
    [display_board.kicad_sch]
2026-02-07 Main board in progress
    [display_board.kicad_pcb, display_board.kicad_sch, hstat-v2.kicad_sch, main_board.kicad_pcb, main_board.kicad_sch]
2026-02-07 Update kicad-lib
2026-02-08 Initial component placement done.
    [display_board.kicad_sch, main_board.kicad_pcb, main_board.kicad_sch]
2026-02-08 Close stuff you dummy.
    [display_board.kicad_pcb]
2026-02-11 Push progress
    [main_board.kicad_pcb, main_board.kicad_sch]
2026-02-12 Start layout
    [main_board.kicad_pcb, main_board.kicad_sch]
2026-02-13 Routing progress
    [main_board.kicad_pcb, main_board.kicad_sch]
2026-02-14 Schematic updates
    [main_board.kicad_pcb, main_board.kicad_sch]
2026-02-14 main board in good spot
    [display_board.kicad_pcb, main_board.kicad_pcb, main_board.kicad_sch]
2026-02-14 Display board in good spot
    [display_board.kicad_pcb, display_board.kicad_sch, main_board.kicad_pcb, main_board.kicad_sch]
2026-02-14 Some more tweaks
    [display_board.kicad_pcb]
2026-02-15 fix symbol
    [display_board.kicad_sch, main_board.kicad_sch]
2026-02-15 Flip touch screen connector
    [display_board.kicad_pcb, display_board.kicad_sch]
2026-02-15 Finalize schematics
    [display_board.kicad_sch]
2026-02-15 Final updates
    [display_board.kicad_pcb, display_board.kicad_sch, main_board.kicad_pcb]
2026-02-15 Remove old single board
    [hstat-v2.kicad_pcb, hstat-v2.kicad_sch]
2026-02-15 Export 3d-models
    [display_board.step]
2026-02-15 Add 3d-models
    [main_board.kicad_pcb]
2026-02-15 Redo high voltage
    [main_board.kicad_pcb, main_board.kicad_sch]
2026-02-15 Close Kicad
2026-02-15 Update 3d models
    [LTR-303ALS-01_LTO.step, TS-1187A-B-A-B.STEP, display_board.kicad_pcb, display_board.step, main_board.kicad_pcb]
2026-02-15 Add LCSC part numbers
    [BOM-display_board.csv, BOM-main_board.csv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]
2026-02-16 Boards ordered
    [BOM-display_board.csv, BOM-main_board.csv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]
2026-02-26 Update connectors
    [BOM-display_board.csv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]
2026-02-26 Update footprint
    [CPL-display_board.csv, display_board-CuBottom.gbr, display_board-CuTop.gbr, display_board-EdgeCuts.gbr, display_board-MaskBottom.gbr, display_board-MaskTop.gbr, display_board-NPTH.drl, display_board-PTH.drl]
2026-02-28 More fixes
    [main_board.csv, main_board.kicad_sch]
2026-04-03 Reorganize tree
    [BOM-display_board.csv, BOM-hstat.csv, BOM-main_board.csv, LTR-303ALS-01_LTO.step, TS-1187A-B-A-B.STEP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]
2026-04-03 Move current SW to package
